TomKeddie/prj-usb-isolator/README.md

# prj-usb-isolator

V1 USB Isolator moved from [vhs-pcbs](https://github.com/TomKeddie/vhs-pcbs/tree/master/usb-isolator)

V2 USB Isolator in smaller form factor with micro usb and disconnector button/input
