TomKeddie/prj-usb-isolator/v2/usb-isolator.brd

## EAGLE design v2/usb-isolator.brd (2019-11-16)

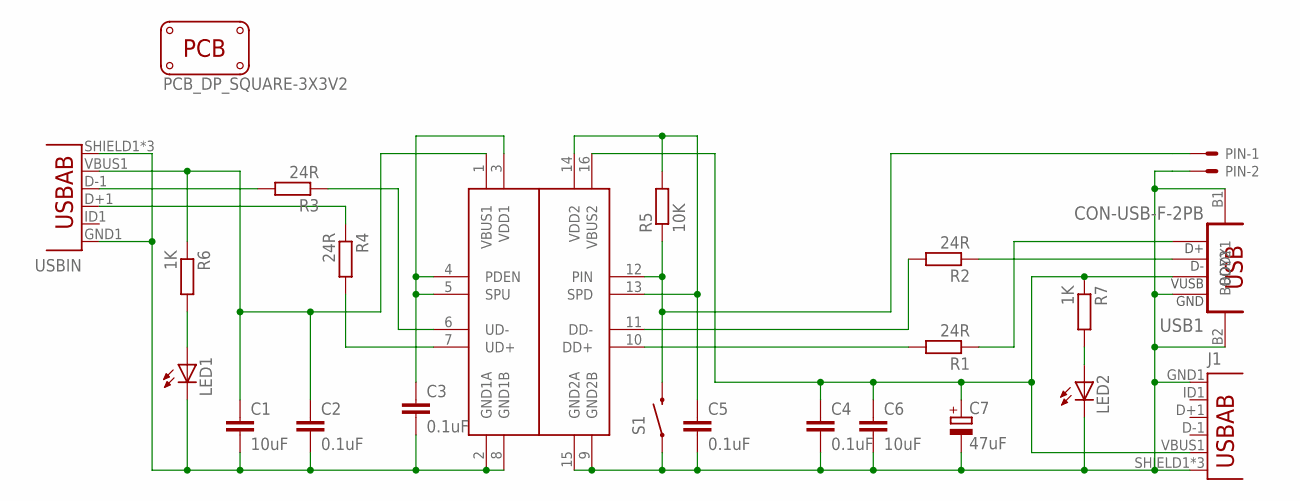
[picture p2: schematic usb-isolator.sch]

Parts:
C1, C6: 10uF; C0805K
C2, C3, C4, C5: 0.1uF; C0603K
C7: 47uF; D/7343-31W
IC1: ADUM3160BRWZ; SO16W
J1: USB-ABCONN-11794; USB-AB-MICRO-SMD_V03
LED1, LED2: LED-0805; LED-805
PIN: 22-23-2021
R1, R2, R3, R4: 24R; R0603
R5: 10K; R0603
R6, R7: 1K; R0603
S1: SWITCH-MOMENTARY-2SMD-1101NE; TACTILE-SWITCH-1101NE
USB1: CON-USB-F-2PB; CONN_USB_A_F
USB-ISOLATOR: PCB_DP_SQUARE-3X3V2; DP3030_V2
USBIN: USB-ABCONN-11794; USB-AB-MICRO-SMD_V03

Connections:
DD_N: R2.1, USB1.2 (D-)
DD_P: R1.1, USB1.3 (D+)
GND1: C1.2, C2.2, C3.2, IC1.2 (GND1A), IC1.8 (GND1B), LED1.C, USBIN.GND1 (GND), USBIN.SHIELD1 (SHIELD), USBIN.SHIELD2 (SHIELD), USBIN.SHIELD3 (SHIELD)
GND2: C4.2, C5.2, C6.2, C7.-, IC1.9 (GND2B), IC1.15 (GND2A), J1.GND1 (GND), J1.SHIELD1 (SHIELD), J1.SHIELD2 (SHIELD), J1.SHIELD3 (SHIELD), LED2.C, PIN.2, S1.1, USB1.4 (GND), USB1.B1 (BODY1), USB1.B2 (BODY2)
unnamed: LED1.A, R6.2
unnamed: LED2.A, R7.2
PIN: IC1.12 (PIN), PIN.1, R5.1, S1.2
R_DD_N: IC1.11 (DD-), R2.2
R_DD_P: IC1.10 (DD+), R1.2
R_UD_N: IC1.6 (UD-), R3.1
R_UD_P: IC1.7 (UD+), R4.2
UD_N: R4.1, USBIN.D+1 (D+)
UD_P: R3.2, USBIN.D-1 (D-)
VBUS1: C1.1, C2.1, IC1.1 (VBUS1), R6.1, USBIN.VBUS1 (VBUS)
VBUS2: C4.1, C6.1, C7.+, IC1.16 (VBUS2), J1.VBUS1 (VBUS), R7.1, USB1.1 (VUSB)
VDD1: C3.1, IC1.3 (VDD1), IC1.4 (PDEN), IC1.5 (SPU)
VDD2: C5.1, IC1.13 (SPD), IC1.14 (VDD2), R5.2

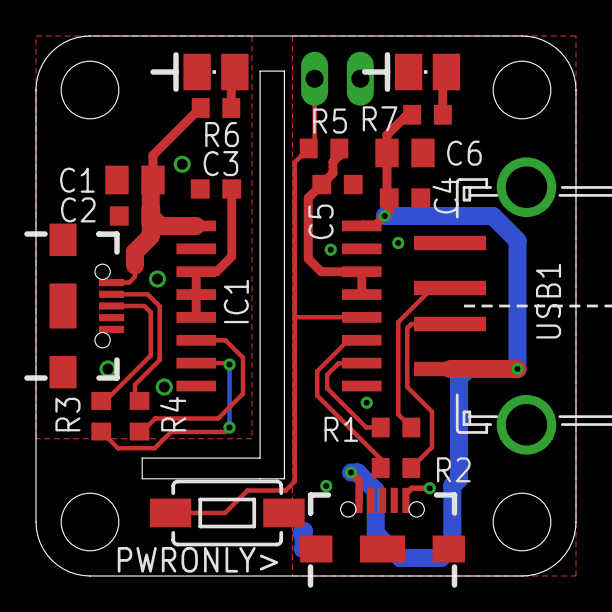
[picture p3: board usb-isolator.brd from above]

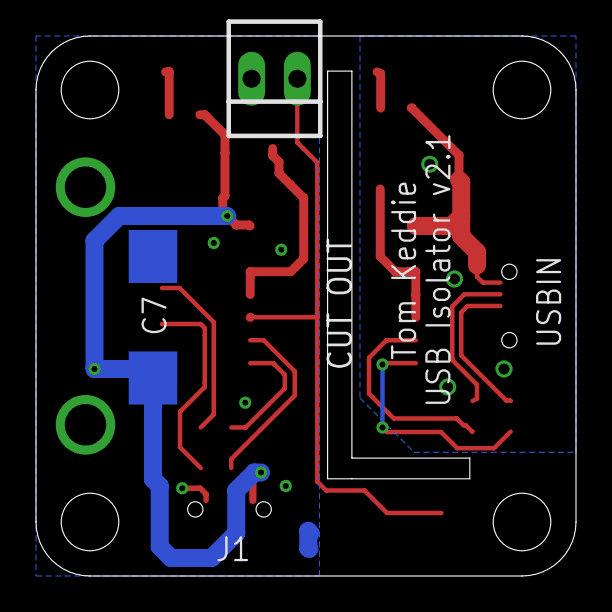
[picture p4: board usb-isolator.brd from below]

Board: 2 copper layers, 30.0 x 30.0 mm, 23 parts (2 on the bottom side), 17 nets.
