TomKeddie/prj-usb-isolator/(commit log)

2014-03-20 Added usb isolator pcb design
    [usb-isolator.brd, usb-isolator.sch]
2014-04-01 Added BOM for usb isolator
2014-04-15 Ad USB isolator workshop materials
2015-01-18 Update README, eagle files and schematic image for rev 1.2
    [usb-isolator.brd, usb-isolator.sch]
2015-03-06 Add GTP for usb-isolator
    [usb-isolator.gtp]
2015-06-29 Added Digikey connector part number from Mike
2017-03-04 Version 2.0 as submitted
    [usb-isolator.brd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]
2018-07-28 Updated usb isolator 2 to move button, add slot
    [usb-isolator.brd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]
2019-11-16 Created usb-isolator repo
    [usb-isolator.brd, usb-isolator.sch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]
2019-11-16 Removed old files, moved v1 into subdirectory
    [usb-isolator.brd, usb-isolator.sch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]
2019-11-16 Moved v2 files into new v2 directory
    [usb-isolator.brd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]
